Maduranga628/Budget_FC/Documents/Budget_FC_top.png

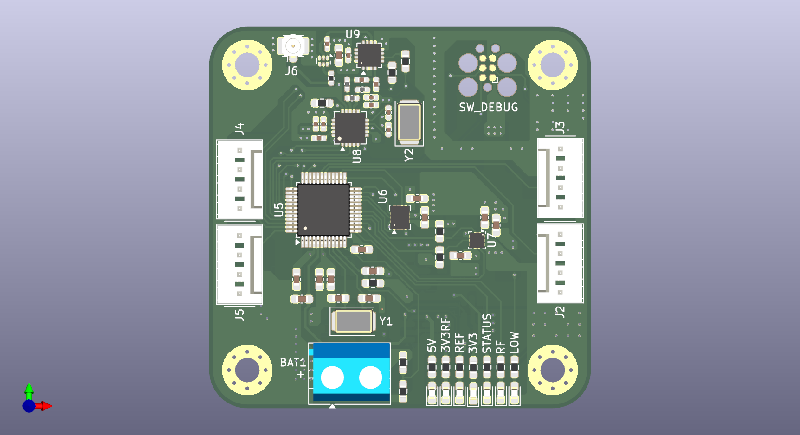
Documents/Budget_FC_top.png
