Maduranga628/Budget_FC/Documents/Budget_FC_bot.png

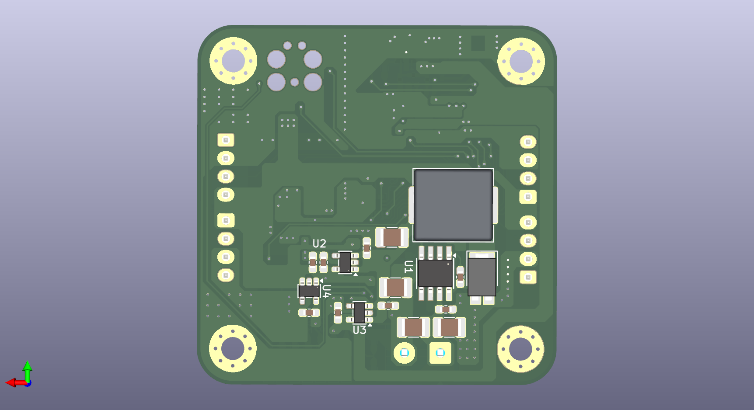
Documents/Budget_FC_bot.png
