Maduranga628/Budget_FC/Documents/Budget_FC.pdf

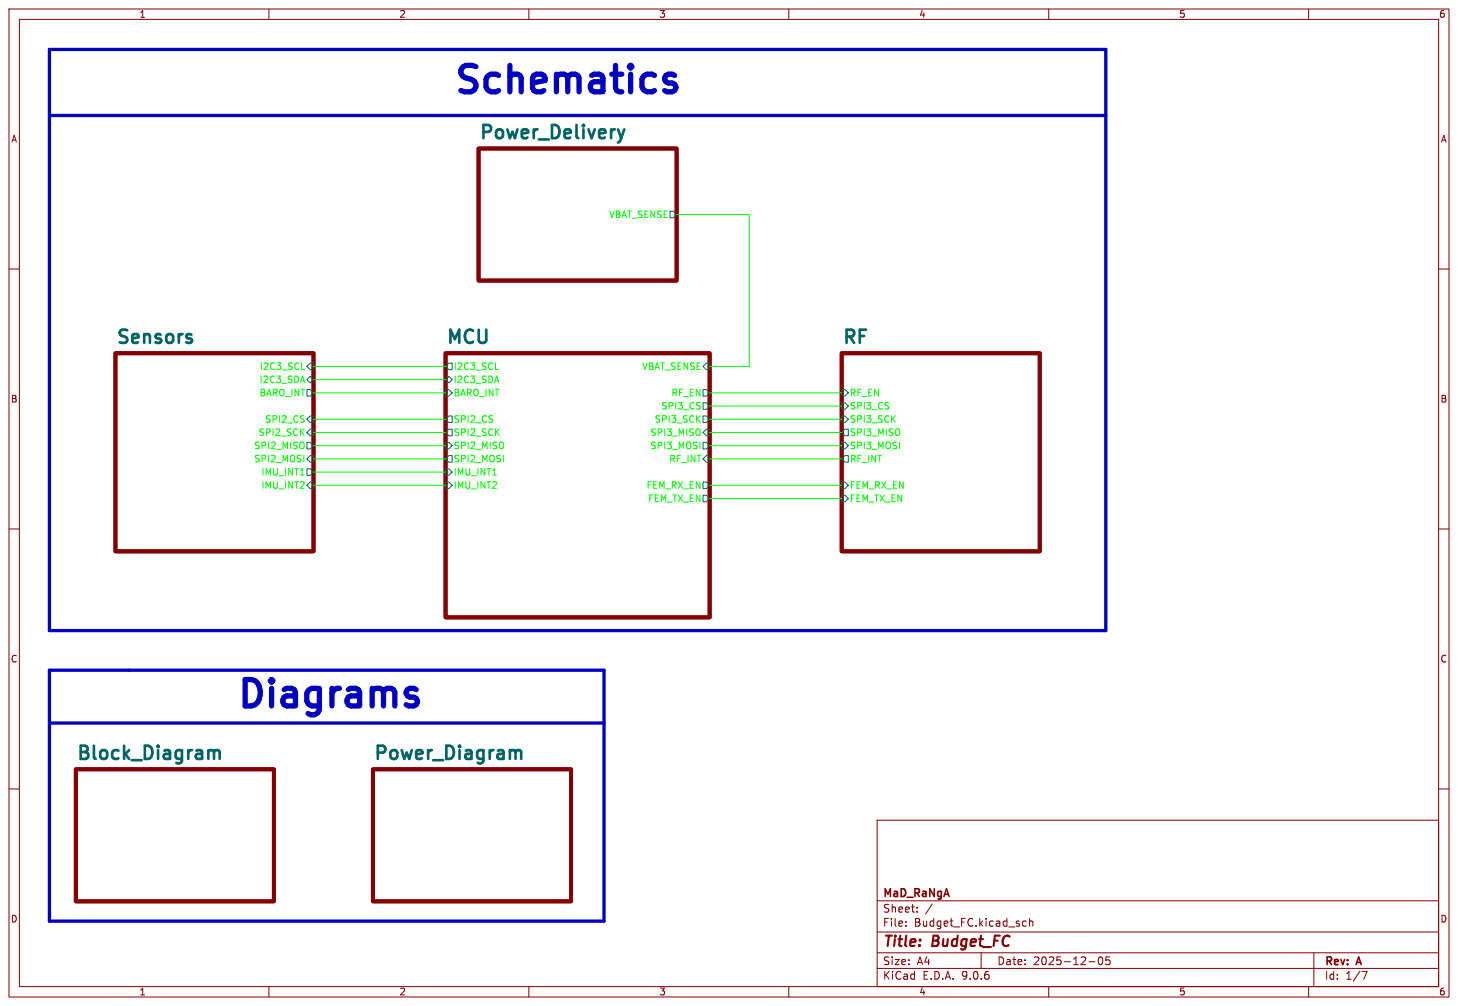
[picture p3: page 1]

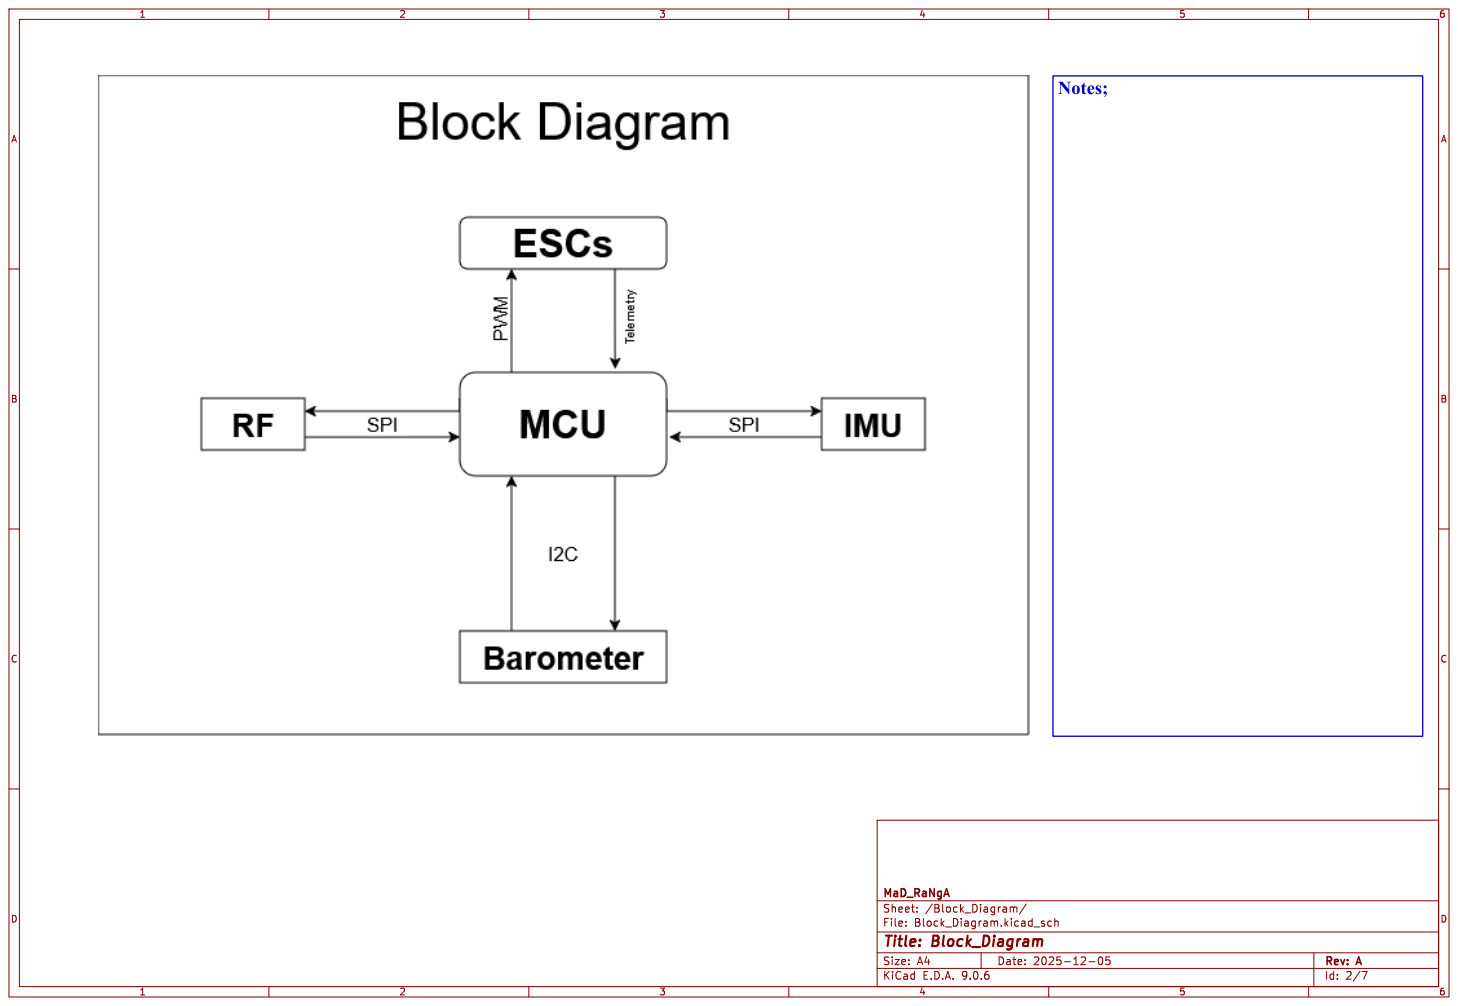
[picture p4: page 2]

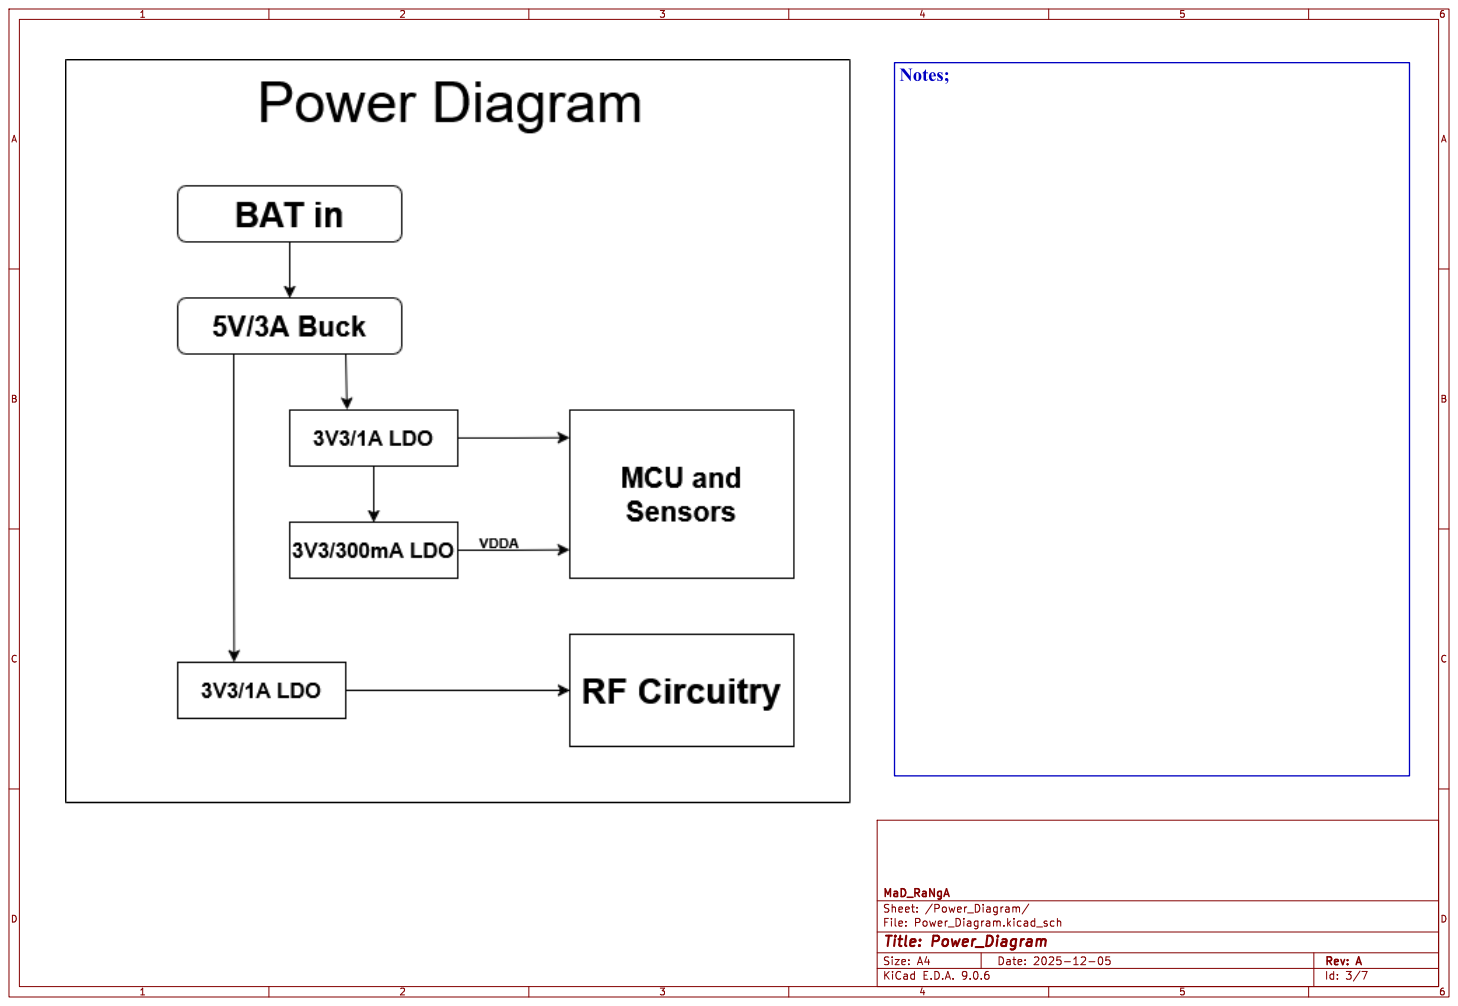
[picture p5: page 3]

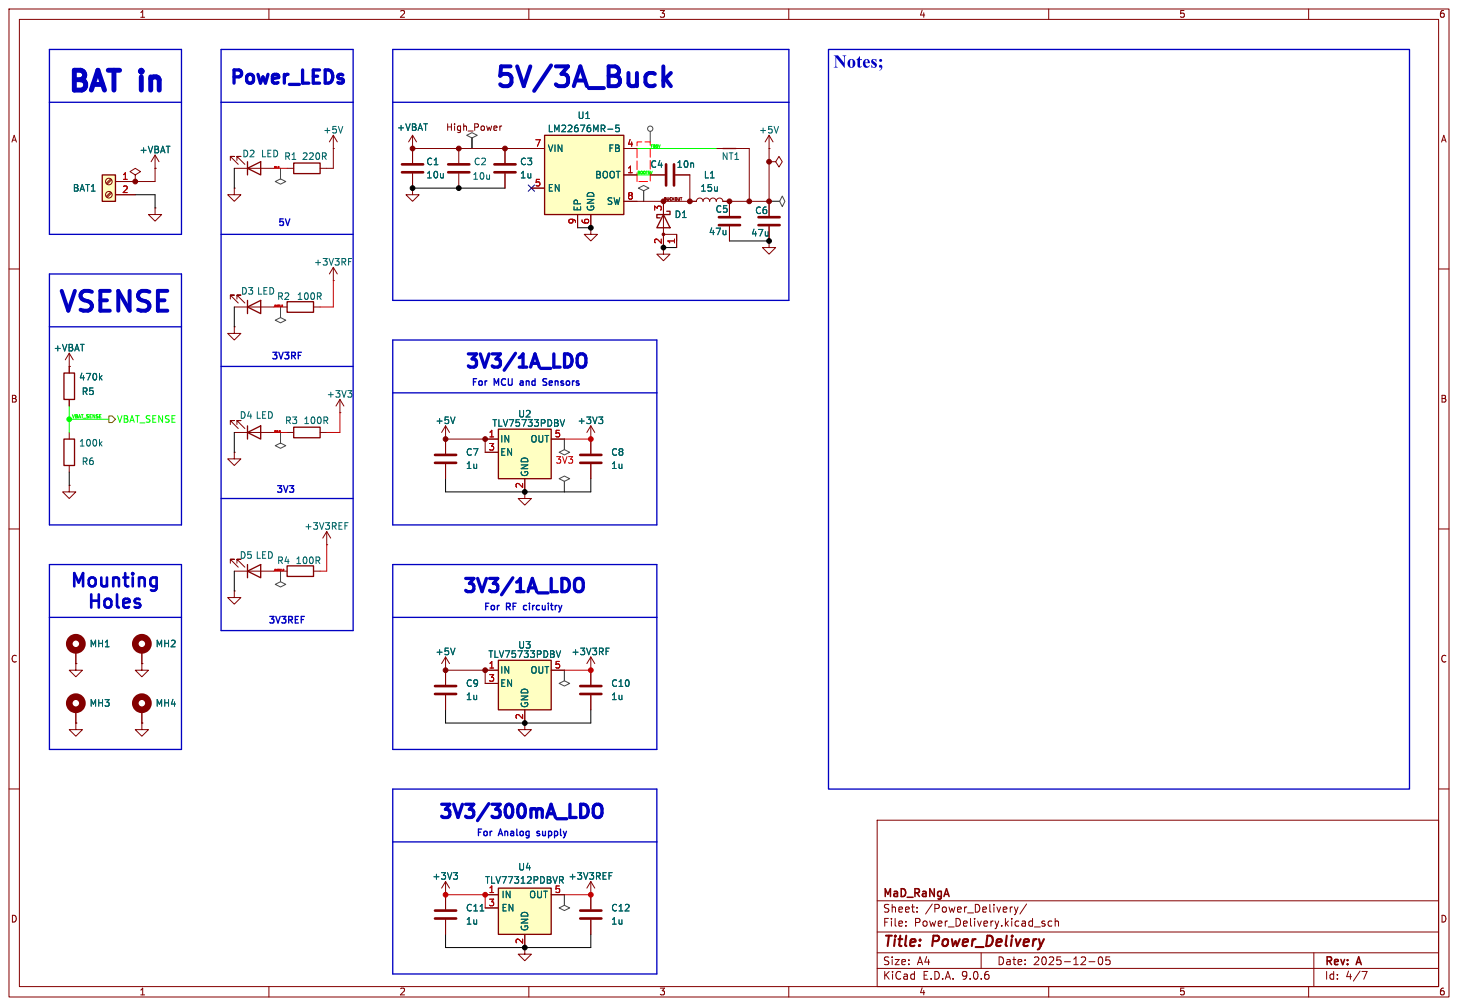
[picture p6: page 4]

For MCU and Sensors

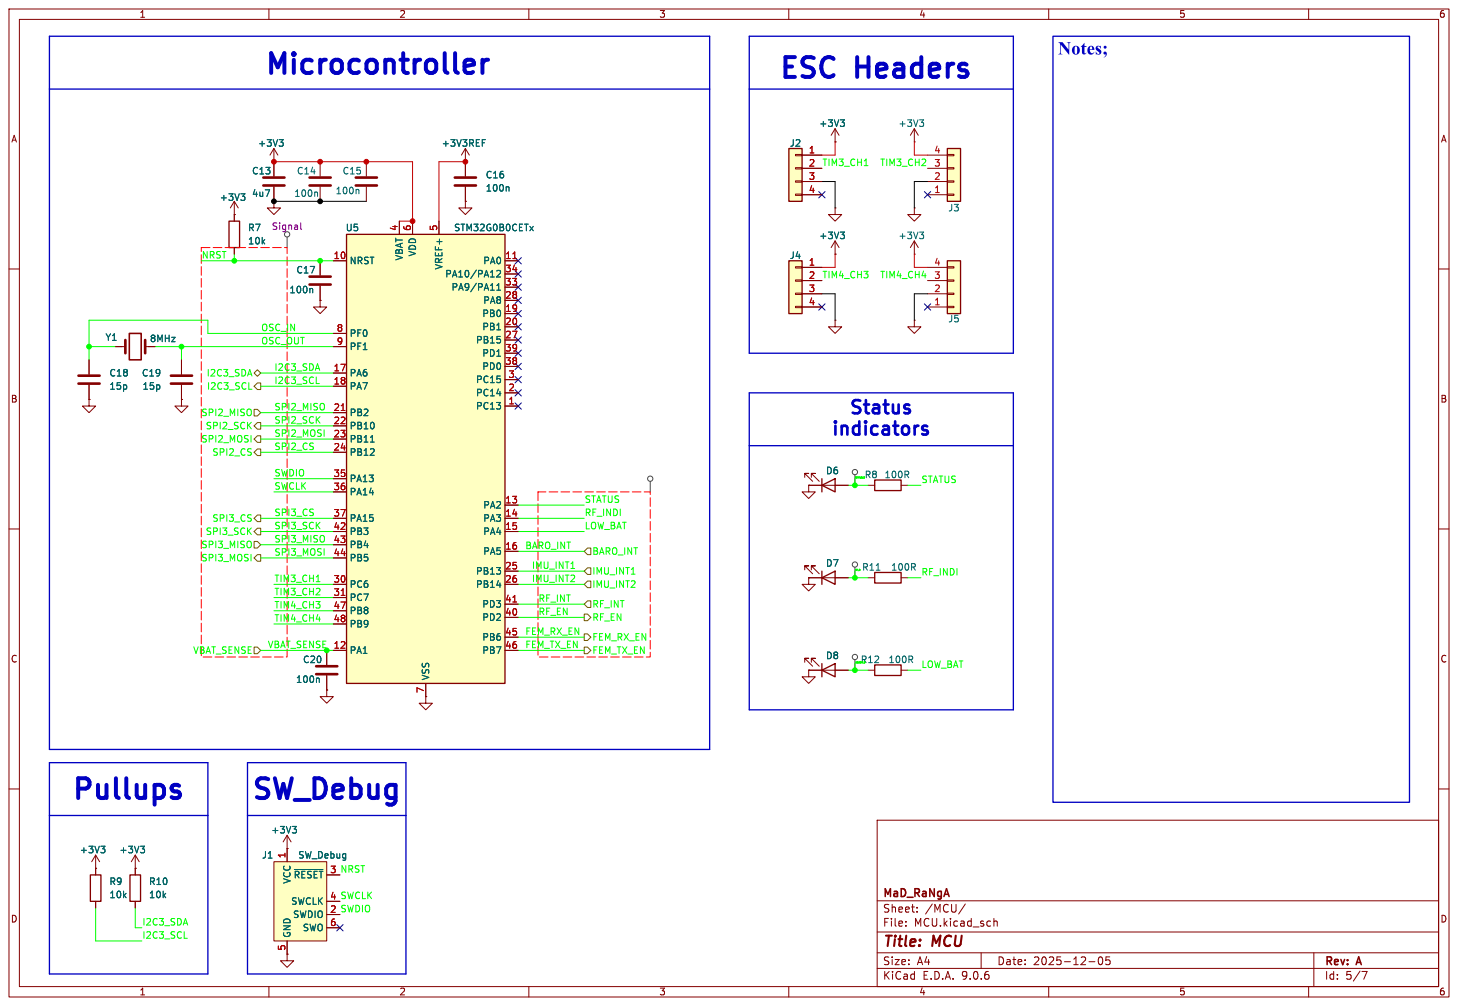
[picture p7: page 5]

File: MCU.kicad_sch Sheet: /MCU/ MaD_RaNgA

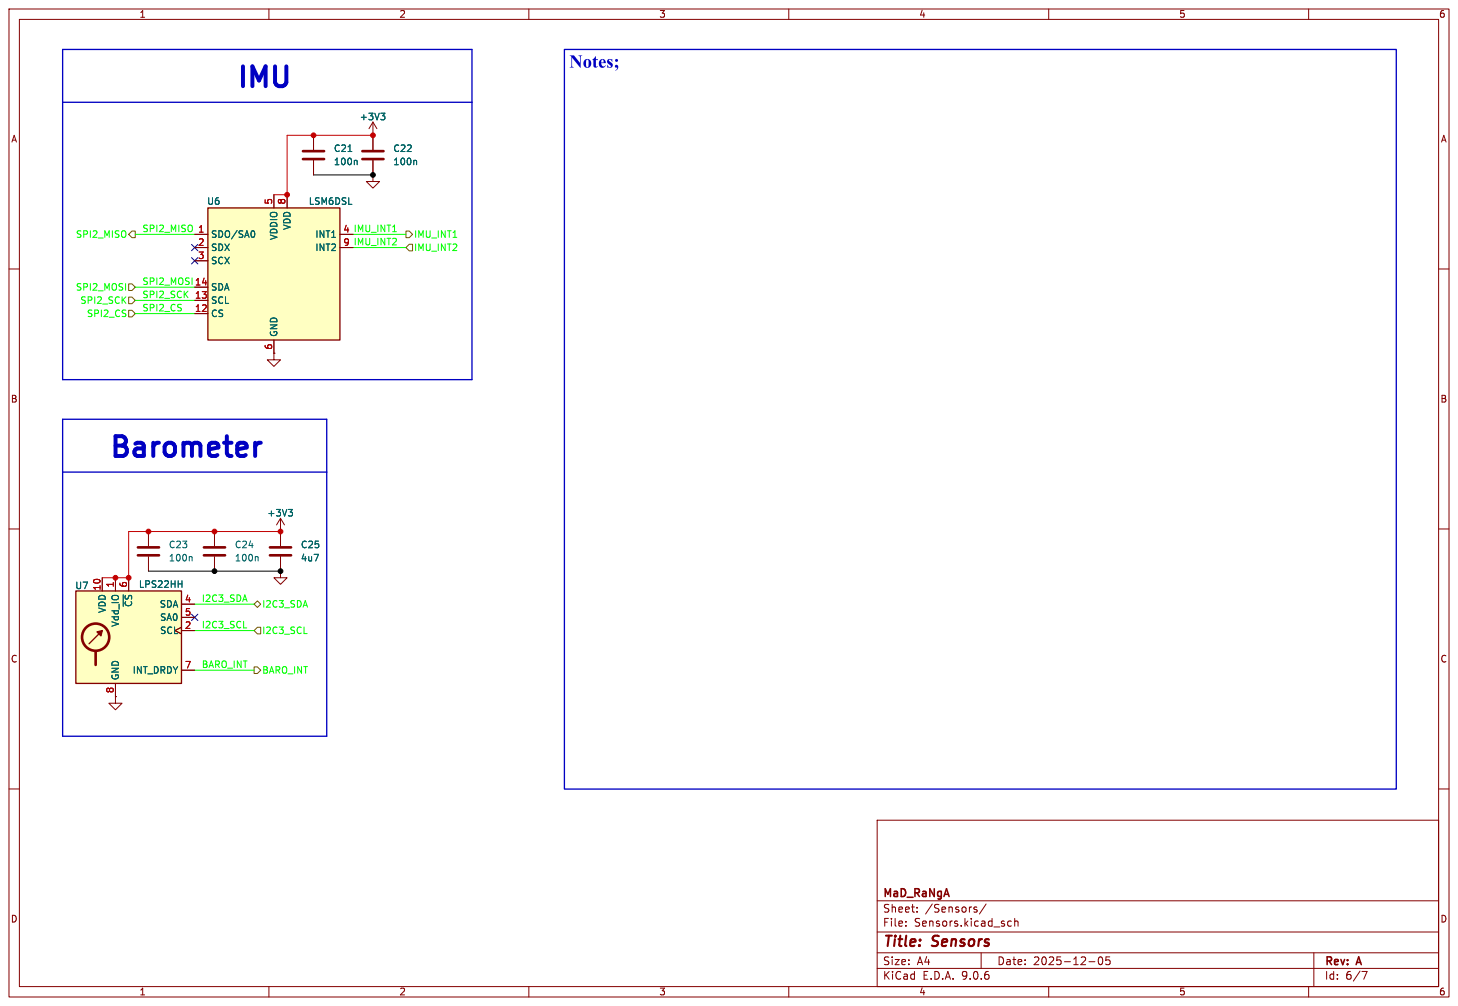
[picture p8: page 6]

File: Sensors.kicad_sch Sheet: /Sensors/ MaD_RaNgA

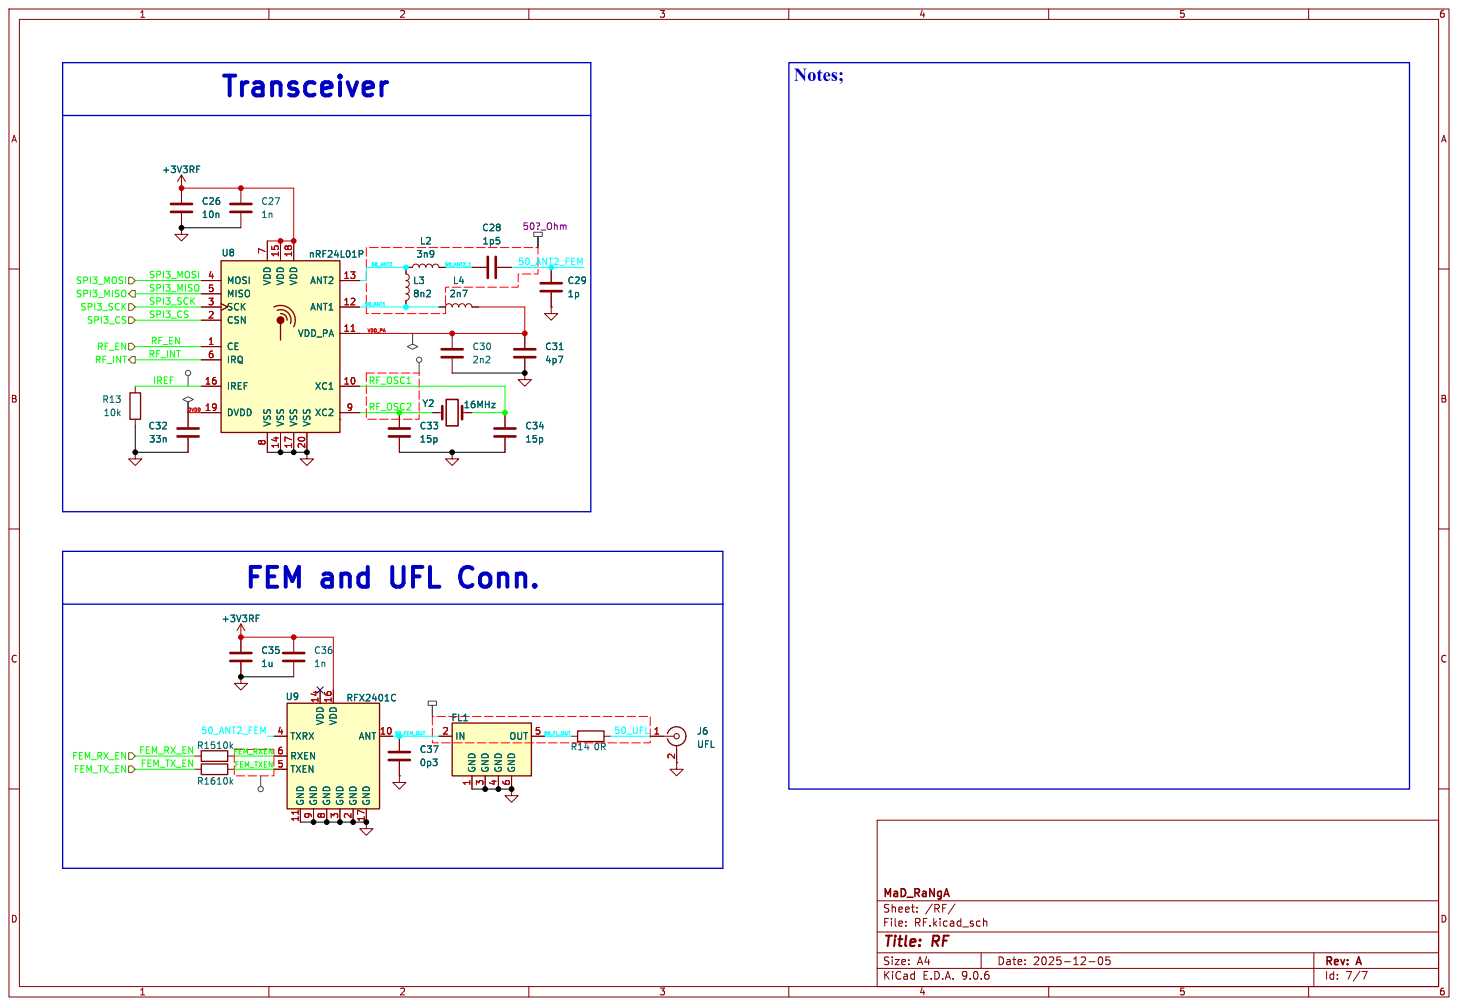
[picture p9: page 7]

8 VDD 15 VSS 14 VDD 18 VSS 17 VSS 20 ANT2 13 ANT1 12 VDD_PA 11 XC1 10 XC2 9 C26

8 VDD 15 VSS 14 VDD 18 VSS 17 VSS 20 ANT2 13 ANT1 12 VDD_PA 11 XC1 10 XC2 9 U8 nRF24L01P

FEM and UFL Conn.

File: RF.kicad_sch Sheet: /RF/ MaD_RaNgA
