Maduranga628/Budget_FC/Documents/Budget_FC_PCB.pdf

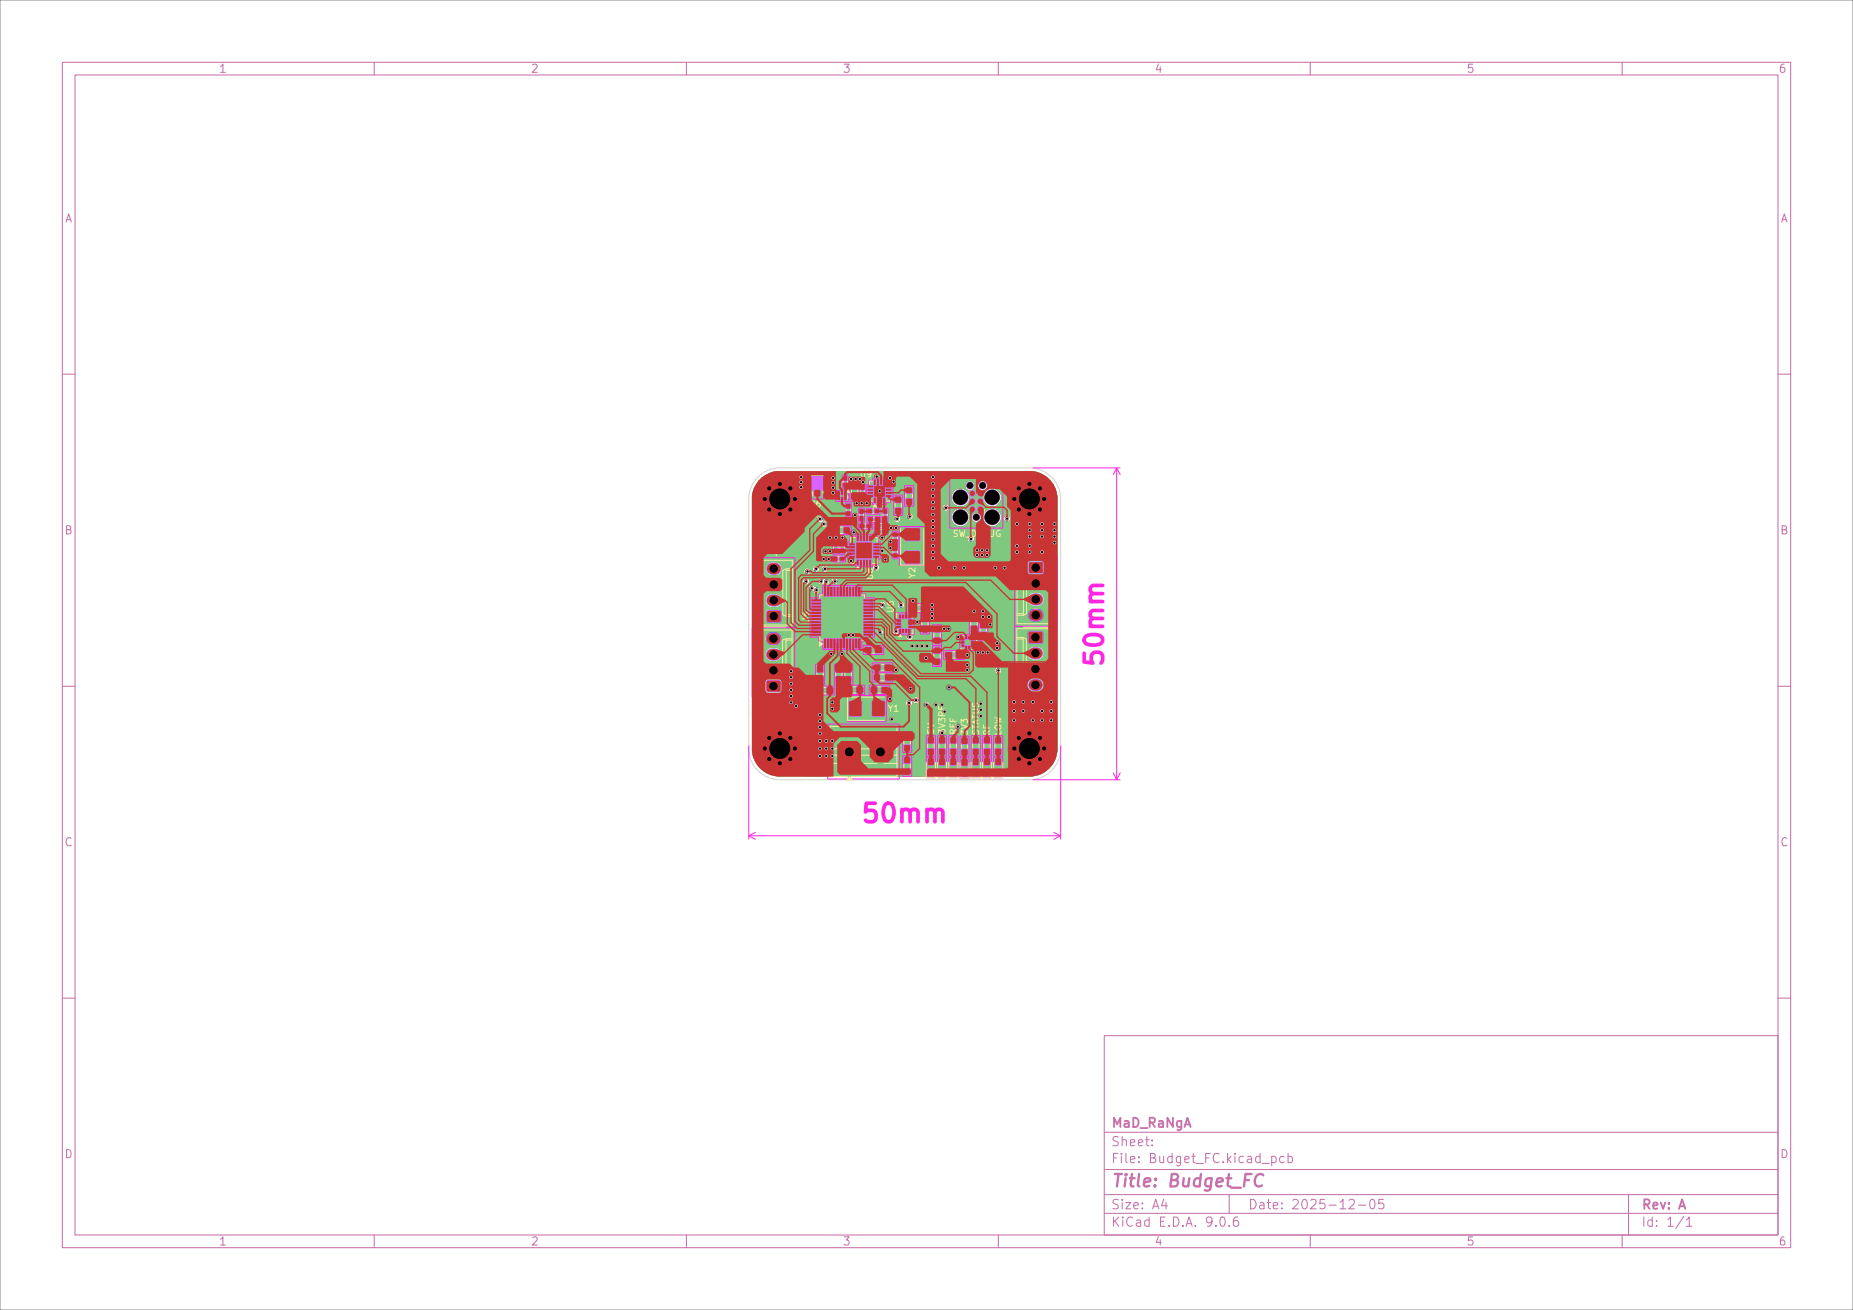
[picture p10: page 1]
