Maduranga628/Budget_FC/Design_Files/Budget_FC.kicad_pcb

## KiCad design Design_Files/Budget_FC.kicad_pcb (2025-12-11)

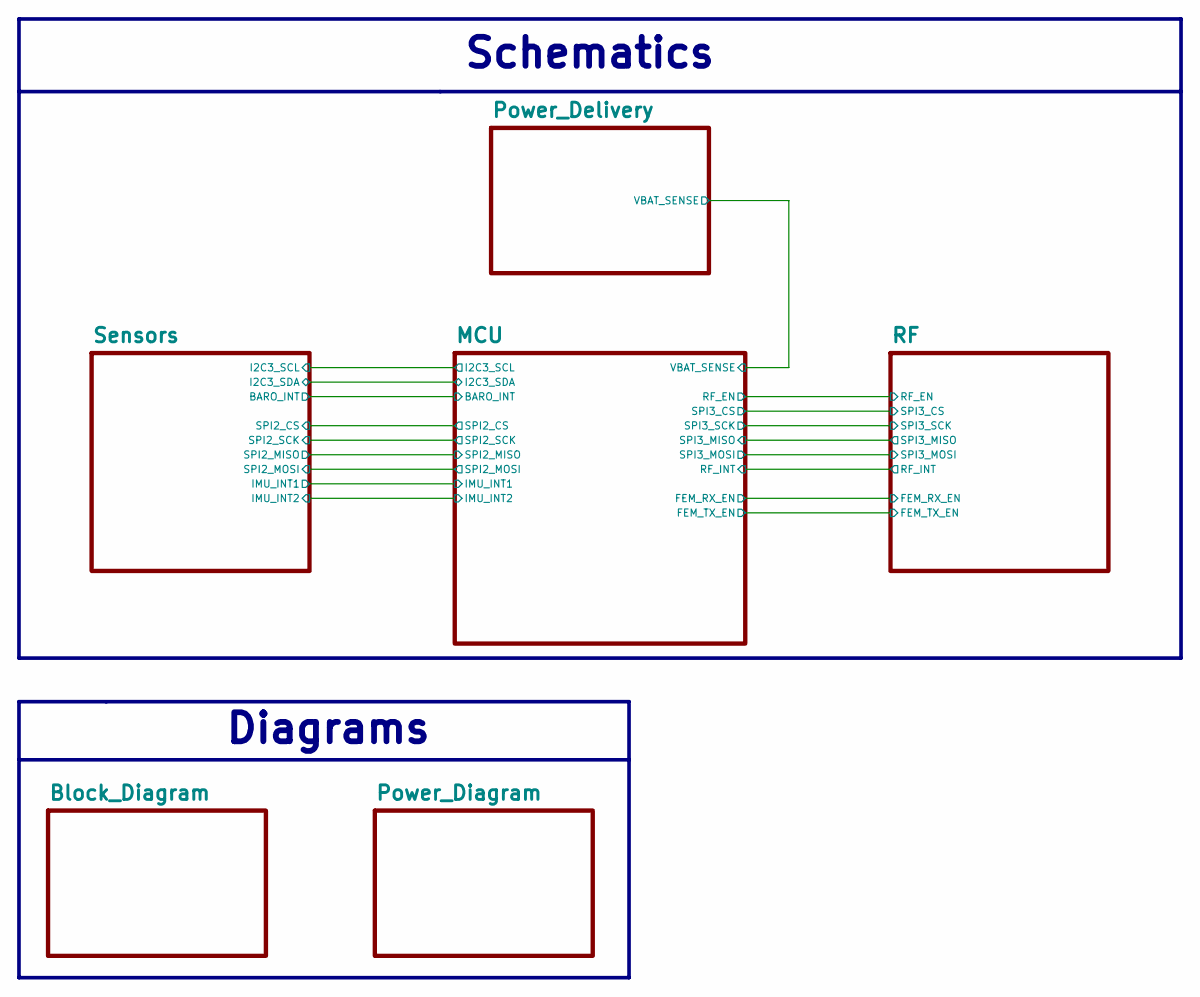
[picture p11: schematic Budget_FC.kicad_sch]

Notes on the sheet:
Schematics
Diagrams

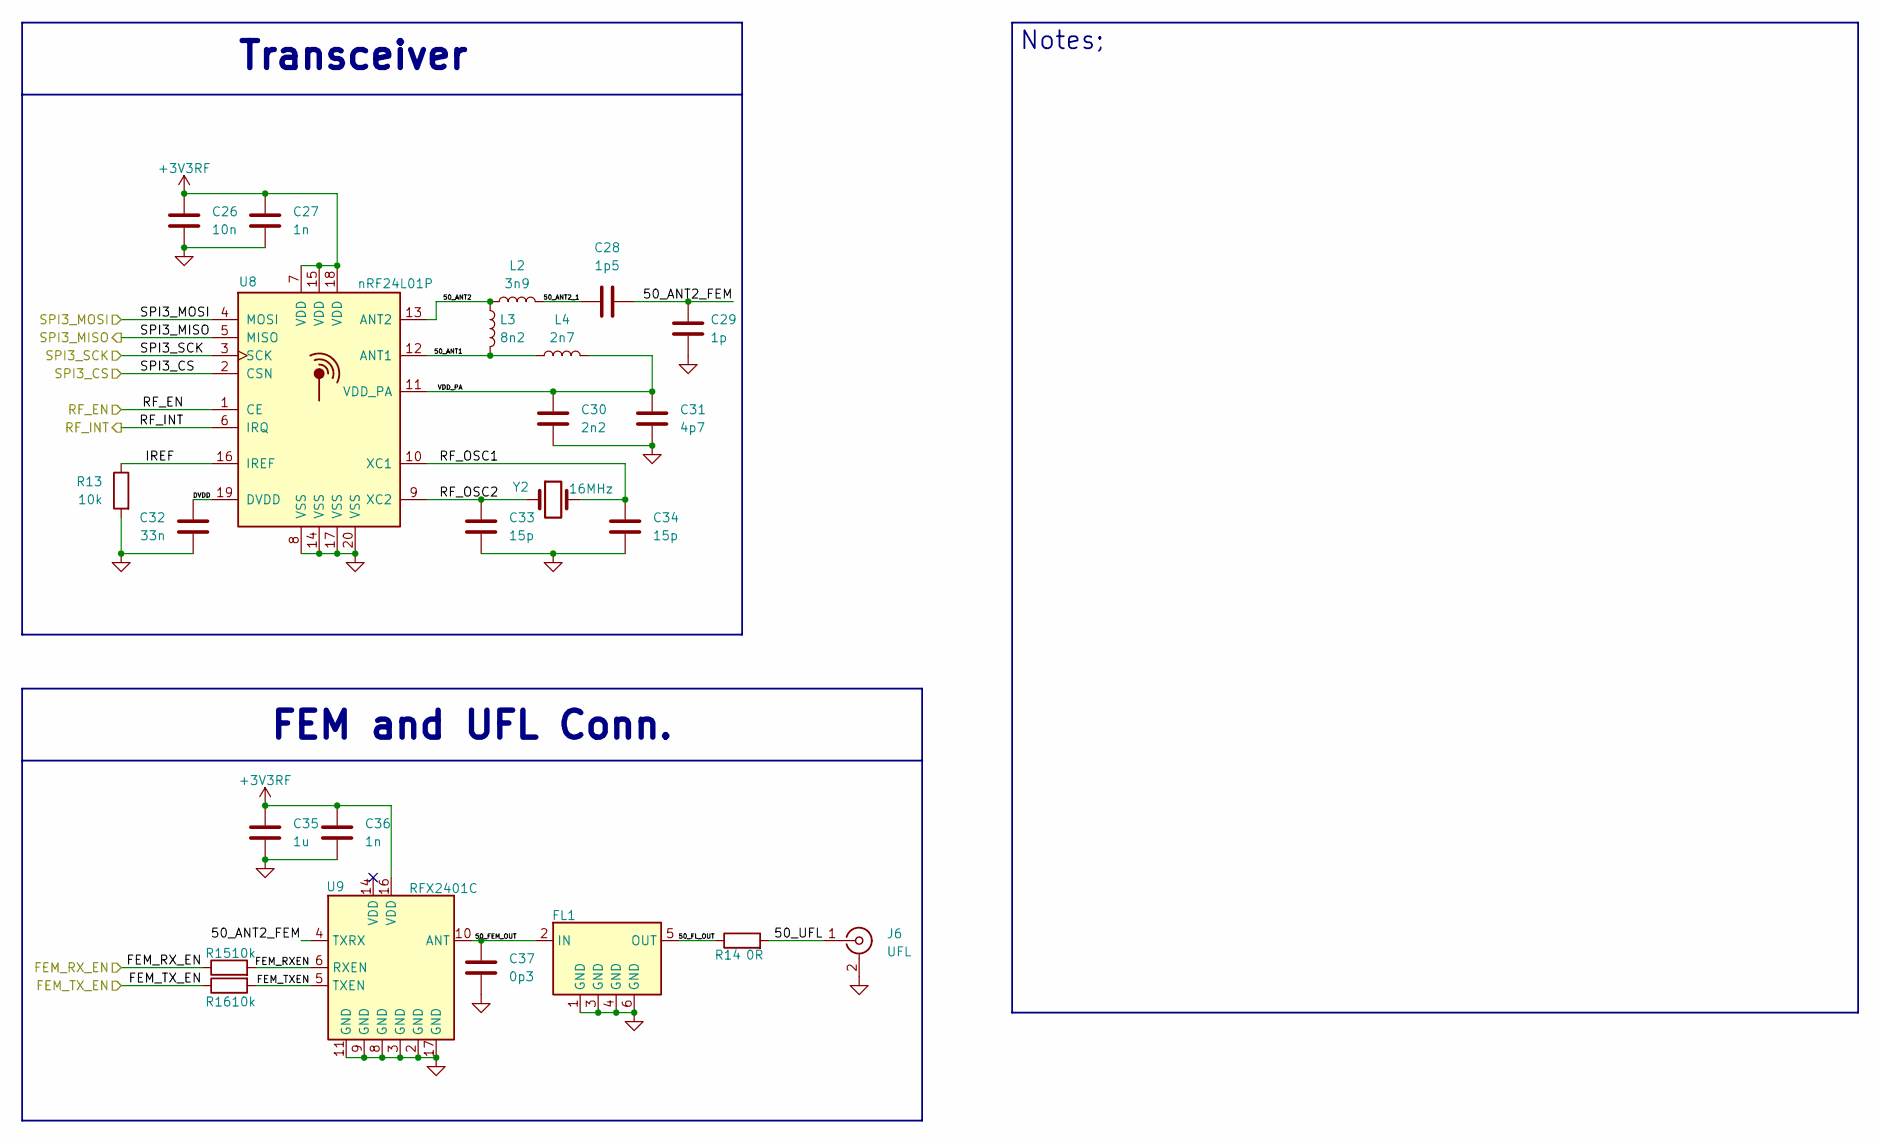
[picture p12: schematic RF.kicad_sch]

Parts:
C26: 10n; C_0402_1005Metric_Pad0.74x0.62mm_HandSolder; Manufacturer Part No. CC0402KRX7R9BB103; LCSC No. C60133
C27, C36: 1n; C_0402_1005Metric_Pad0.74x0.62mm_HandSolder; Manufacturer Part No. CC0402KRX7R9BB102; LCSC No. C106205
C28: 1p5; C_0402_1005Metric_Pad0.74x0.62mm_HandSolder; Manufacturer Part No. CC0402CRNPO9BN1R5; LCSC No. C189471
C29: 1p; C_0402_1005Metric_Pad0.74x0.62mm_HandSolder; Manufacturer Part No. CC0402CRNPO9BN1R0; LCSC No. C277493
C30: 2n2; C_0402_1005Metric_Pad0.74x0.62mm_HandSolder; Manufacturer Part No. CC0402KRX7R9BB222; LCSC No. C106861
C31: 4p7; C_0402_1005Metric_Pad0.74x0.62mm_HandSolder; Manufacturer Part No. CC0402CRNPO9BN4R7; LCSC No. C189469
C32: 33n; C_0402_1005Metric_Pad0.74x0.62mm_HandSolder; Manufacturer Part No. CC0402KRX7R9BB333; LCSC No. C106862
C33, C34: 15p; C_0402_1005Metric_Pad0.74x0.62mm_HandSolder; Manufacturer Part No. CC0402FRNPO9BN150; LCSC No. C326803
C35: 1u; C_0603_1608Metric_Pad1.08x0.95mm_HandSolder; Manufacturer Part No. C1608X5R1E105K080AC; Mouser No. 810-C1608X5R1E105K
C37: 0p3; C_0402_1005Metric_Pad0.74x0.62mm_HandSolder; Manufacturer Part No. CQ0402BRNPO9BNR30; LCSC No. C723570
FL1: 2450LP14A0100001T; Balun_Johanson_1.6x0.8mm; Manufacturer Part No. 2450LP14A0100001T; LCSC No. C17651741
J6: UFL; U.FL_Hirose_U.FL-R-SMT-1_Vertical
L2: 3n9; L_0402_1005Metric_Pad0.77x0.64mm_HandSolder; Manufacturer Part No. CS0402-3N9J-S; LCSC No. C329623
L3: 8n2; L_0402_1005Metric_Pad0.77x0.64mm_HandSolder; Manufacturer Part No. CLH1005T-8N2J-S; LCSC No. C108262
L4: 2n7; L_0402_1005Metric_Pad0.77x0.64mm_HandSolder; Manufacturer Part No. CS0402-2N7J-S; LCSC No. C142181
R13: 10k; R_0603_1608Metric_Pad0.98x0.95mm_HandSolder; Manufacturer Part No. RC0603FR-0722KL; LCSC No. C114065
R14: 0R; R_0402_1005Metric_Pad0.72x0.64mm_HandSolder; Manufacturer Part No. RC0402FR-070RL; LCSC No. C106231
R15, R16: 10k; R_0603_1608Metric_Pad0.98x0.95mm_HandSolder; Manufacturer Part No. RC0603FR-0710KL; LCSC No. C98220
U8: nRF24L01P; QFN-20-1EP_4x4mm_P0.5mm_EP2.5x2.5mm; Manufacturer Part No. NRF24L01P-R7; Mouser No. 949-NRF24L01P-R7
U9: RFX2401C; QFN-16-1EP_3x3mm_P0.5mm_EP1.7x1.7mm; Manufacturer Part No. RFX2401C; Mouser No. 477-RFX2401C
Y2: 16MHz; Crystal_SMD_5032-2Pin_5.0x3.2mm; Manufacturer Part No. 0153G2-16.000F12DTLJL; LCSC No. C19674297

Connections:
+3V3RF: C26.1, C27.1, C35.1, C36.1, U8.7 (VDD), U8.15 (VDD), U8.18 (VDD), U9.16 (VDD); also elsewhere on the board
/MCU/FEM_RX_EN: R15.1; also elsewhere on the board
/MCU/FEM_TX_EN: R16.1; also elsewhere on the board
/MCU/RF_EN: U8.1 (CE); also elsewhere on the board
/MCU/RF_INT: U8.6 (IRQ); also elsewhere on the board
/MCU/SPI3_CS: U8.2 (CSN); also elsewhere on the board
/MCU/SPI3_MISO: U8.5 (MISO); also elsewhere on the board
/MCU/SPI3_MOSI: U8.4 (MOSI); also elsewhere on the board
/MCU/SPI3_SCK: U8.3 (SCK); also elsewhere on the board
/RF/50_ANT1: L3.2, L4.1, U8.12 (ANT1)
/RF/50_ANT2: L2.1, L3.1, U8.13 (ANT2)
/RF/50_ANT2_1: C28.1, L2.2
/RF/50_ANT2_FEM: C28.2, C29.1, U9.4 (TXRX)
/RF/50_FEM_OUT: C37.1, FL1.2 (IN), U9.10 (ANT)
/RF/50_FL_OUT: FL1.5 (OUT), R14.1
/RF/50_UFL: J6.1 (In), R14.2
/RF/DVDD: C32.1, U8.19 (DVDD)
/RF/FEM_RXEN: R15.2, U9.6 (RXEN)
/RF/FEM_TXEN: R16.2, U9.5 (TXEN)
/RF/IREF: R13.1, U8.16 (IREF)
/RF/RF_OSC1: C34.1, U8.10 (XC1), Y2.2
/RF/RF_OSC2: C33.1, U8.9 (XC2), Y2.1
/RF/VDD_PA: C30.1, C31.1, L4.2, U8.11 (VDD_PA)
GND: C26.2, C27.2, C29.2, C30.2, C31.2, C32.2, C33.2, C34.2, C35.2, C36.2, C37.2, FL1.1 (GND), FL1.3 (GND), FL1.4 (GND), FL1.6 (GND), J6.2 (Ext), R13.2, U8.8 (VSS), U8.14 (VSS), U8.17 (VSS), U8.20 (VSS), U9.2 (GND), U9.3 (GND), U9.8 (GND), U9.9 (GND), U9.11 (GND), U9.17 (GND); also elsewhere on the board

Notes on the sheet:
Transceiver
FEM and UFL Conn.
Notes;

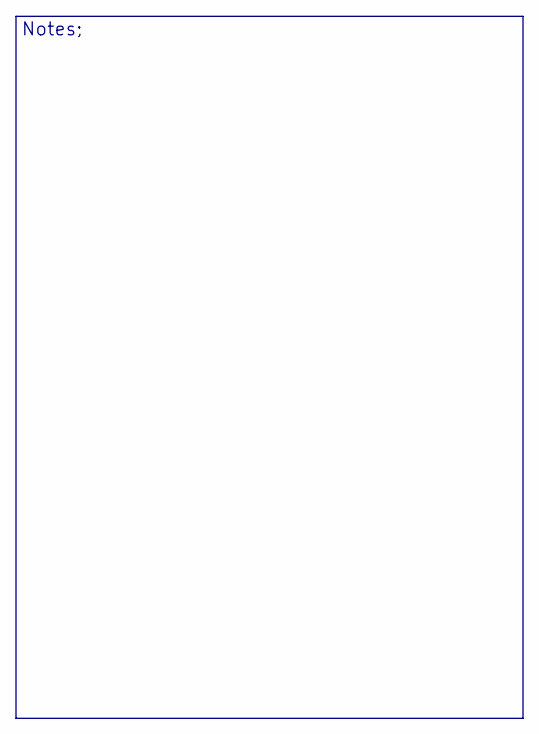
[picture p13: schematic Power_Diagram.kicad_sch]

Notes on the sheet:
Notes;

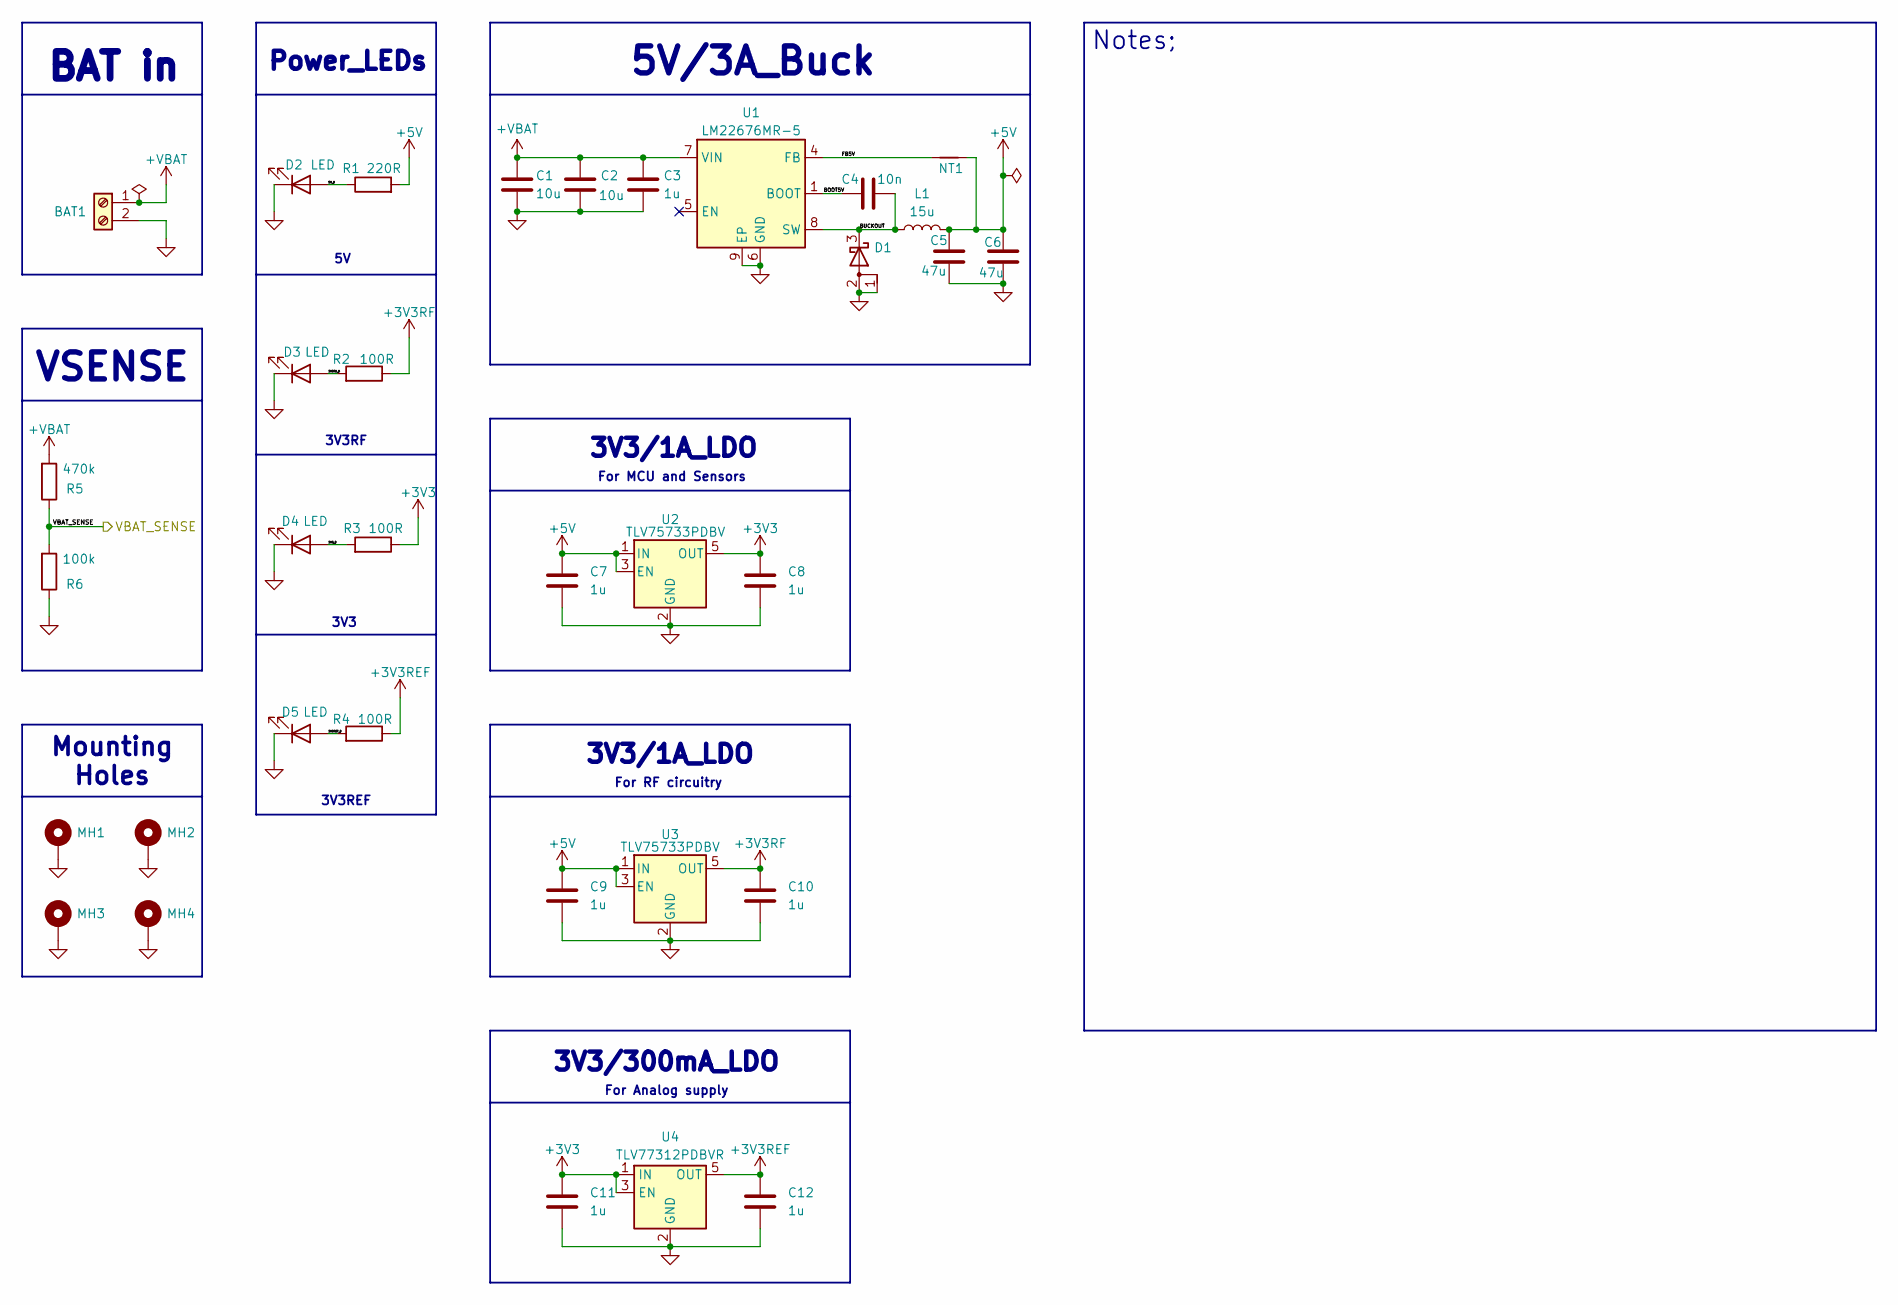
[picture p14: schematic Power_Delivery.kicad_sch]

Parts:
BAT1: Screw_Terminal_01x02; TerminalBlock_MaiXu_MX126-5.0-02P_1x02_P5.00mm_3d
C1, C2: 10u; C_1210_3225Metric_Pad1.33x2.70mm_HandSolder; Manufacturer Part No. C3225X7R1H106M250AC; Mouser No. 810-C3225X7R1H106MAC
C3, C7, C8, C9, C10, C11, C12: 1u; C_0603_1608Metric_Pad1.08x0.95mm_HandSolder; Manufacturer Part No. C1608X5R1E105K080AC; Mouser No. 810-C1608X5R1E105K
C4: 10n; C_0603_1608Metric_Pad1.08x0.95mm_HandSolder; Manufacturer Part No. C0603C103K5RACTU; Mouser No. 80-C0603C103K5R
C5, C6: 47u; C_1210_3225Metric_Pad1.33x2.70mm_HandSolder; Manufacturer Part No. GRM32ER61C476KE15L; Mouser No. 81-GRM32ER61C476KE5L
D1: D_Schottky_AAK; Diode_SMD_D_PowerDI-5; Manufacturer Part No. PDS760-13; Mouser No. 621-PDS760-F
D2, D3, D4, D5: LED; LED_0603_1608Metric_Pad1.05x0.95mm_HandSolder; Manufacturer Part No. XL-1608UBC-04; LCSC No. C965807
L1: 15u; L_Bourns_SRP1050WA; Manufacturer Part No. ZD1040-150M; LCSC No. C46956567
MH1, MH2, MH3, MH4: MountingHole_Pad; MountingHole_3.2mm_M3_Pad_Via
NT1: NetTie_2; NetTie-2_SMD_Pad0.5mm
R1: 220R; R_0603_1608Metric_Pad0.98x0.95mm_HandSolder; Manufacturer Part No. RC0603FR-07220RL; LCSC No. C107696
R2, R3, R4: 100R; R_0603_1608Metric_Pad0.98x0.95mm_HandSolder; Manufacturer Part No. RC0603FR-07100RL; LCSC No. C105588
R5: 470k; R_0603_1608Metric_Pad0.98x0.95mm_HandSolder; Manufacturer Part No. RC0603FR-07470KL; LCSC No. C114622
R6: 100k; R_0603_1608Metric_Pad0.98x0.95mm_HandSolder; Manufacturer Part No. RC0603FR-07100KL; LCSC No. C14675
U1: LM22676MR-5; TI_SO-PowerPAD-8; Manufacturer Part No. LM22676QMRX-5.0/NOPB; Mouser No. 926-LM22676QMRX50NPB
U2, U3: TLV75733PDBV; SOT-23-5; Manufacturer Part No. TLV75733PDBVR; Mouser No. 595-TLV75733PDBVR
U4: TLV77312PDBVR; SOT-23-5; Manufacturer Part No. TLV77312PDBVR; Mouser No. 595-TLV77312PDBVR

Connections:
+3V3: C8.1, C11.1, R3.1, U2.5 (OUT), U4.1 (IN), U4.3 (EN); also elsewhere on the board
+3V3REF: C12.1, R4.1, U4.5 (OUT); also elsewhere on the board
+3V3RF: C10.1, R2.1, U3.5 (OUT); also elsewhere on the board
+5V: C5.1, C6.1, C7.1, C9.1, L1.2, NT1.2, R1.2, U2.1 (IN), U2.3 (EN), U3.1 (IN), U3.3 (EN)
+VBAT: BAT1.1, C1.1, C2.1, C3.1, R5.2, U1.7 (VIN)
/MCU/VBAT_SENSE: R5.1, R6.2; also elsewhere on the board
/Power_Delivery/3V3REF_D: D5.2 (A), R4.2; also elsewhere on the board
/Power_Delivery/3V3RF_D: D3.2 (A), R2.2; also elsewhere on the board
/Power_Delivery/3V3_D: D4.2 (A), R3.2; also elsewhere on the board
/Power_Delivery/5V_D: D2.2 (A), R1.1; also elsewhere on the board
/Power_Delivery/BOOT5V: C4.1, U1.1 (BOOT)
/Power_Delivery/BUCKOUT: C4.2, D1.3 (K), L1.1, U1.8 (SW)
/Power_Delivery/FB5V: NT1.1, U1.4 (FB)
GND: BAT1.2, C1.2, C2.2, C3.2, C5.2, C6.2, C7.2, C8.2, C9.2, C10.2, C11.2, C12.2, D1.1 (A), D1.2 (A), D2.1 (K), D3.1 (K), D4.1 (K), D5.1 (K), MH1.1, MH2.1, MH3.1, MH4.1, R6.1, U1.6 (GND), U1.9 (EP), U2.2 (GND), U3.2 (GND), U4.2 (GND); also elsewhere on the board

Notes on the sheet:
3V3/1A_LDO
3V3RF
BAT in
Mounting Holes
3V3REF
Power_LEDs
5V/3A_Buck
For MCU and Sensors
For Analog supply
VSENSE
3V3/300mA_LDO
3V3
For RF circuitry
Notes;

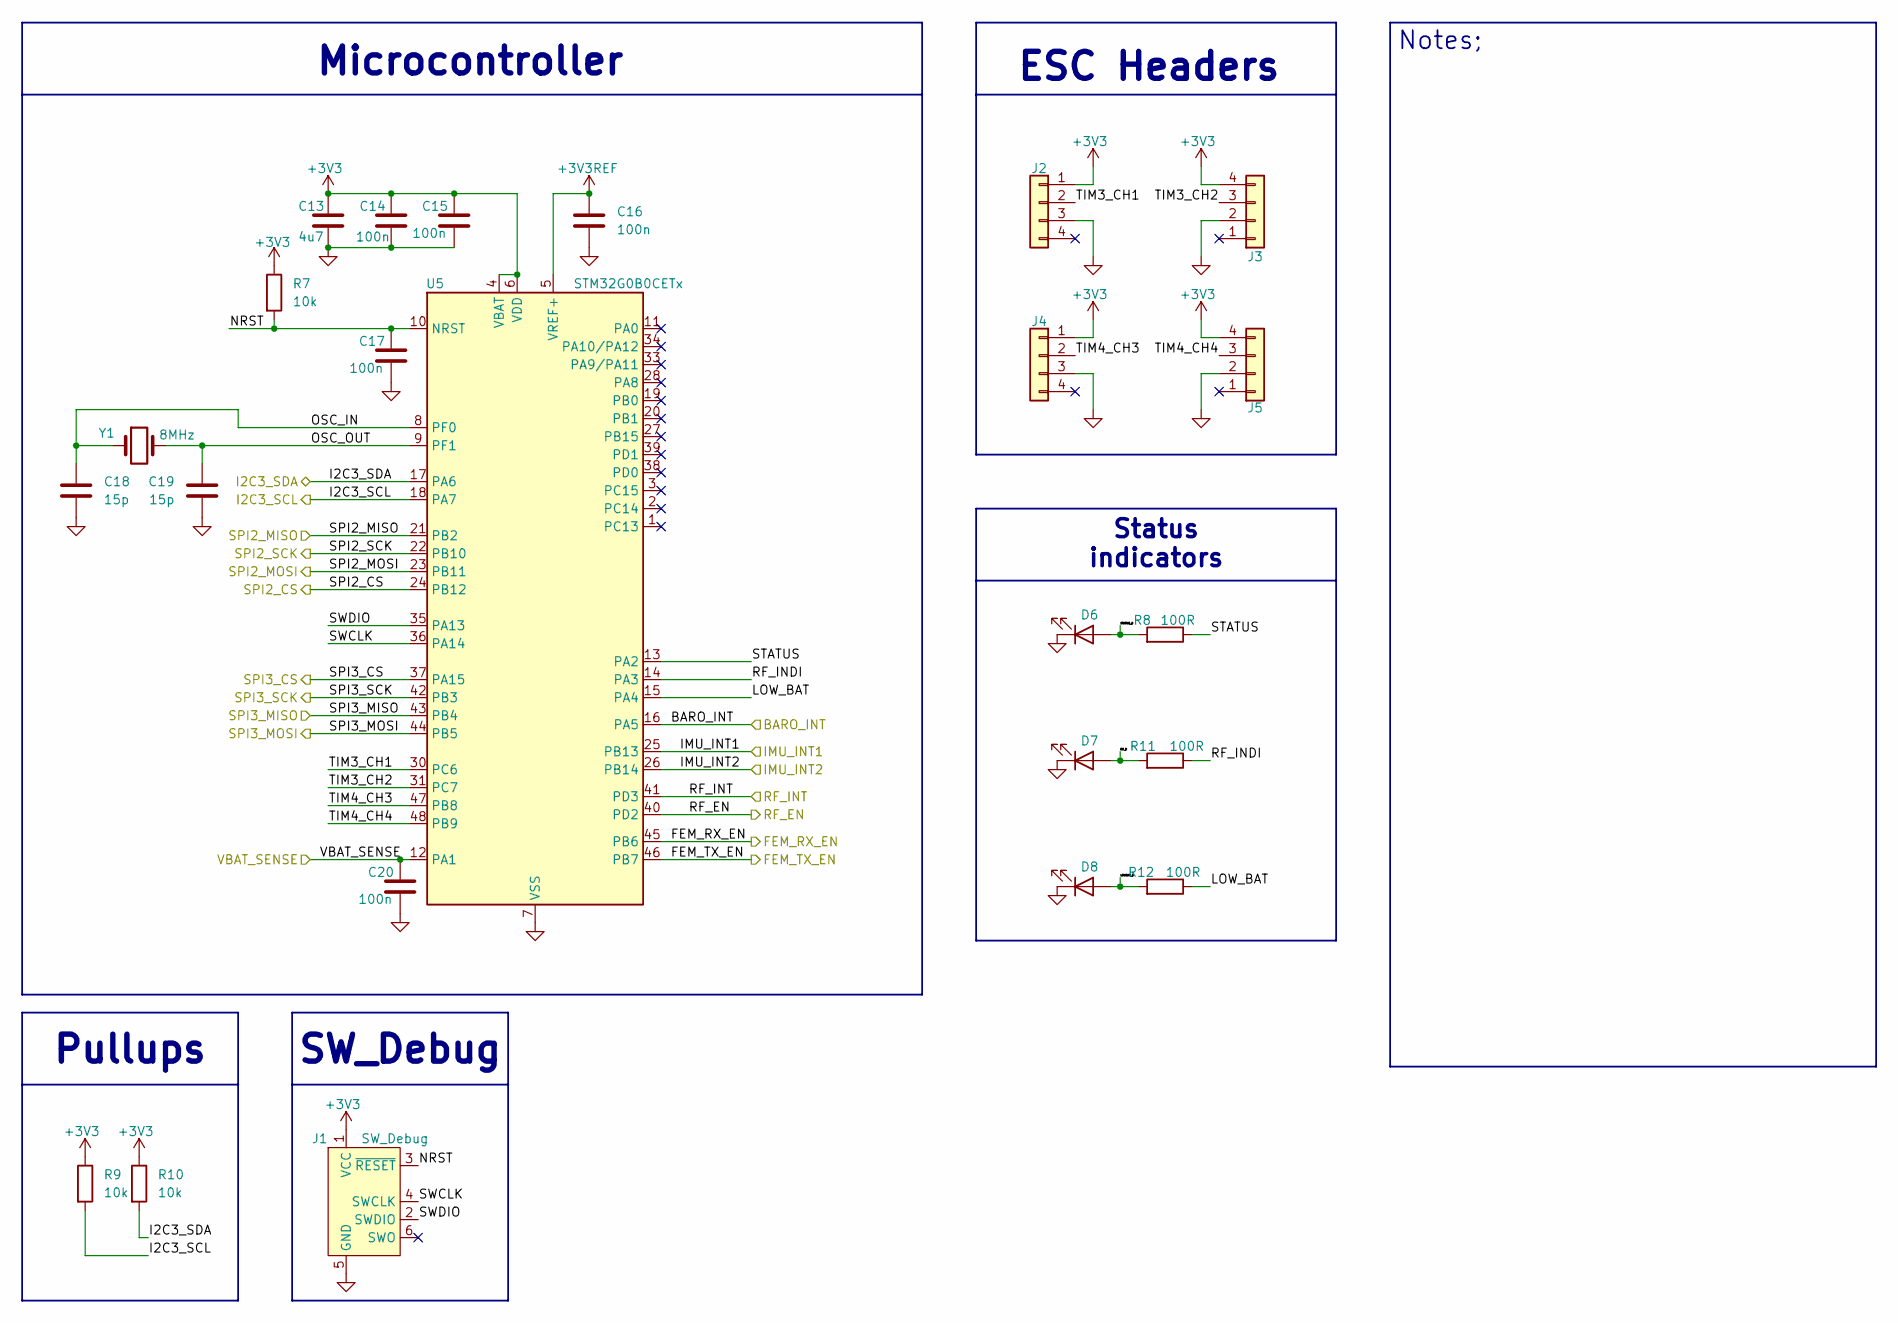
[picture p15: schematic MCU.kicad_sch]

Parts:
C13: 4u7; C_0603_1608Metric_Pad1.08x0.95mm_HandSolder; Manufacturer Part No. CC0603KRX5R6BB475; LCSC No. C109456
C14, C15, C16, C17, C20: 100n; C_0603_1608Metric_Pad1.08x0.95mm_HandSolder; Manufacturer Part No. CC0603KRX7R6BB104; LCSC No. C519438
C18, C19: 15p; C_0603_1608Metric_Pad1.08x0.95mm_HandSolder; Manufacturer Part No. CC0603JRNPO9BN150; LCSC No. C107037
D6, D7, D8: LED; LED_0603_1608Metric_Pad1.05x0.95mm_HandSolder; Manufacturer Part No. XL-1608UBC-04; LCSC No. C965807
J1: SW_Debug; Tag-Connect_TC2030-IDC-FP_2x03_P1.27mm_Vertical
J2, J3, J4, J5: Conn_01x04; Molex_KK-254_AE-6410-04A_1x04_P2.54mm_Vertical
R7, R9, R10: 10k; R_0603_1608Metric_Pad0.98x0.95mm_HandSolder; Manufacturer Part No. RC0603FR-0710KL; LCSC No. C98220
R8, R11, R12: 100R; R_0603_1608Metric_Pad0.98x0.95mm_HandSolder; Manufacturer Part No. RC0603FR-07100RL; LCSC No. C105588
U5: STM32G0B0CETx; LQFP-48_7x7mm_P0.5mm; Manufacturer Part No. STM32G0B0CET6TR; Mouser No. 511-STM32G0B0CET6TR
Y1: 8MHz; Crystal_SMD_5032-2Pin_5.0x3.2mm; Manufacturer Part No. XC53G2-8.000-F12NJHP; LCSC No. C2842269

Connections:
+3V3: C13.1, C14.1, C15.1, J1.1 (VCC), J2.1, J3.4, J4.1, J5.4, R7.1, R9.1, R10.1, U5.4 (VBAT), U5.6 (VDD); also elsewhere on the board
+3V3REF: C16.1, U5.5 (VREF+); also elsewhere on the board
/MCU/BARO_INT: U5.16 (PA5); also elsewhere on the board
/MCU/FEM_RX_EN: U5.45 (PB6); also elsewhere on the board
/MCU/FEM_TX_EN: U5.46 (PB7); also elsewhere on the board
/MCU/I2C3_SCL: R9.2, U5.18 (PA7); also elsewhere on the board
/MCU/I2C3_SDA: R10.2, U5.17 (PA6); also elsewhere on the board
/MCU/IMU_INT1: U5.25 (PB13); also elsewhere on the board
/MCU/IMU_INT2: U5.26 (PB14); also elsewhere on the board
/MCU/LOWBAT_D: D8.2 (A), R12.2; also elsewhere on the board
/MCU/LOW_BAT: R12.1, U5.15 (PA4)
/MCU/NRST: C17.1, J1.3 (~RESET), R7.2, U5.10 (NRST); also elsewhere on the board
/MCU/OSC_IN: C18.1, U5.8 (PF0), Y1.1
/MCU/OSC_OUT: C19.1, U5.9 (PF1), Y1.2
/MCU/RF_D: D7.2 (A), R11.2; also elsewhere on the board
/MCU/RF_EN: U5.40 (PD2); also elsewhere on the board
/MCU/RF_INDI: R11.1, U5.14 (PA3)
/MCU/RF_INT: U5.41 (PD3); also elsewhere on the board
/MCU/SPI2_CS: U5.24 (PB12); also elsewhere on the board
/MCU/SPI2_MISO: U5.21 (PB2); also elsewhere on the board
/MCU/SPI2_MOSI: U5.23 (PB11); also elsewhere on the board
/MCU/SPI2_SCK: U5.22 (PB10); also elsewhere on the board
/MCU/SPI3_CS: U5.37 (PA15); also elsewhere on the board
/MCU/SPI3_MISO: U5.43 (PB4); also elsewhere on the board
/MCU/SPI3_MOSI: U5.44 (PB5); also elsewhere on the board
/MCU/SPI3_SCK: U5.42 (PB3); also elsewhere on the board
/MCU/STATUS: R8.1, U5.13 (PA2)
/MCU/STATUS_D: D6.2 (A), R8.2; also elsewhere on the board
/MCU/SWCLK: J1.4 (SWCLK), U5.36 (PA14); also elsewhere on the board
/MCU/SWDIO: J1.2 (SWDIO), U5.35 (PA13); also elsewhere on the board
/MCU/TIM3_CH1: J2.2, U5.30 (PC6)
/MCU/TIM3_CH2: J3.3, U5.31 (PC7)
/MCU/TIM4_CH3: J4.2, U5.47 (PB8)
/MCU/TIM4_CH4: J5.3, U5.48 (PB9)
/MCU/VBAT_SENSE: C20.1, U5.12 (PA1); also elsewhere on the board
GND: C13.2, C14.2, C15.2, C16.2, C17.2, C18.2, C19.2, C20.2, D6.1 (K), D7.1 (K), D8.1 (K), J1.5 (GND), J2.3, J3.2, J4.3, J5.2, U5.7 (VSS); also elsewhere on the board

Notes on the sheet:
Pullups
SW_Debug
ESC Headers
Microcontroller
Status indicators
Notes;

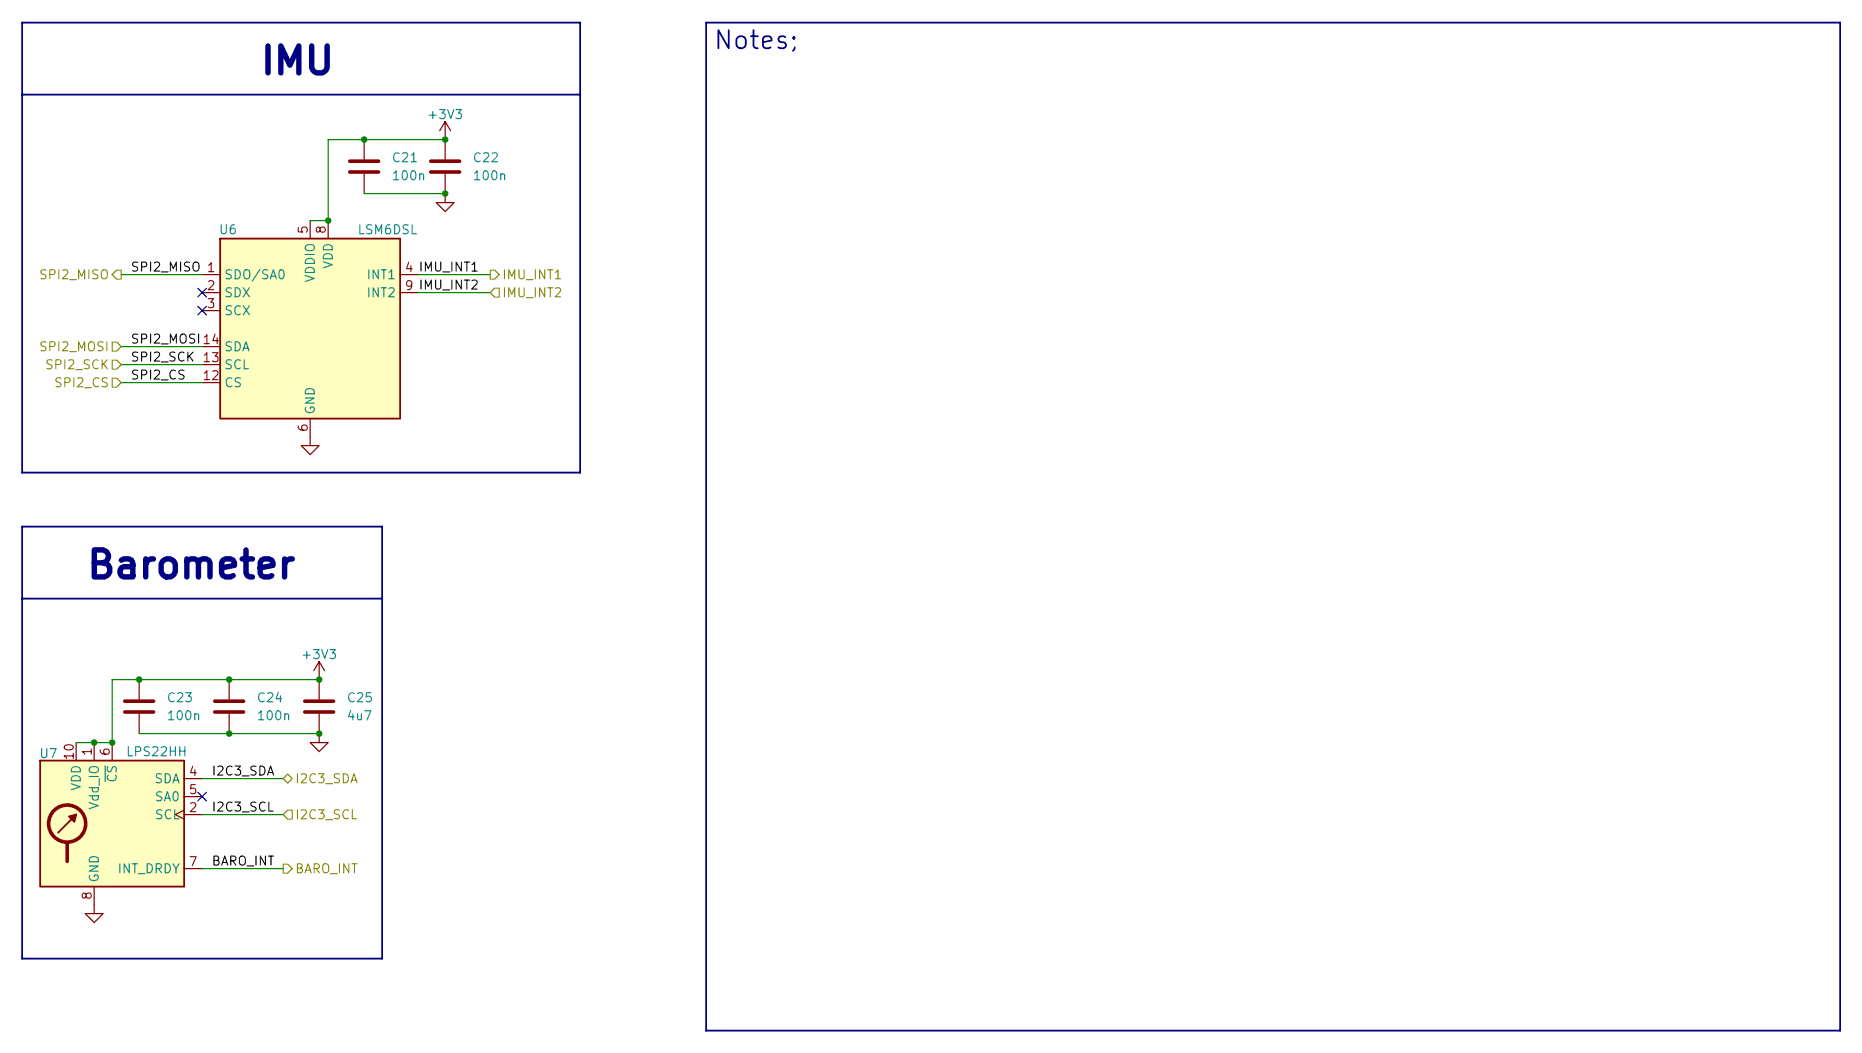
[picture p16: schematic Sensors.kicad_sch]

Parts:
C21, C22, C23, C24: 100n; C_0603_1608Metric_Pad1.08x0.95mm_HandSolder; Manufacturer Part No. CC0603KRX7R6BB104; LCSC No. C519438
C25: 4u7; C_0603_1608Metric_Pad1.08x0.95mm_HandSolder; Manufacturer Part No. CC0603KRX5R6BB475; LCSC No. C109456
U6: LSM6DSL; LGA-14_3x2.5mm_P0.5mm_LayoutBorder3x4y; Manufacturer Part No. LSM6DSLTR; Mouser No. 511-LSM6DSLTR
U7: LPS22HH; ST_HLGA-10_2x2mm_P0.5mm_LayoutBorder3x2y; Manufacturer Part No. LPS22HHTR; Mouser No. 511-LPS22HHTR

Connections:
+3V3: C21.1, C22.1, C23.1, C24.1, C25.1, U6.5 (VDDIO), U6.8 (VDD), U7.1 (Vdd_IO), U7.6 (~CS), U7.10 (VDD); also elsewhere on the board
/MCU/BARO_INT: U7.7 (INT_DRDY); also elsewhere on the board
/MCU/I2C3_SCL: U7.2 (SCL); also elsewhere on the board
/MCU/I2C3_SDA: U7.4 (SDA); also elsewhere on the board
/MCU/IMU_INT1: U6.4 (INT1); also elsewhere on the board
/MCU/IMU_INT2: U6.9 (INT2); also elsewhere on the board
/MCU/SPI2_CS: U6.12 (CS); also elsewhere on the board
/MCU/SPI2_MISO: U6.1 (SDO/SA0); also elsewhere on the board
/MCU/SPI2_MOSI: U6.14 (SDA); also elsewhere on the board
/MCU/SPI2_SCK: U6.13 (SCL); also elsewhere on the board
GND: C21.2, C22.2, C23.2, C24.2, C25.2, U6.6 (GND), U6.7 (GND), U7.3 (GND), U7.8 (GND), U7.9 (GND); also elsewhere on the board

Notes on the sheet:
Barometer
IMU
Notes;

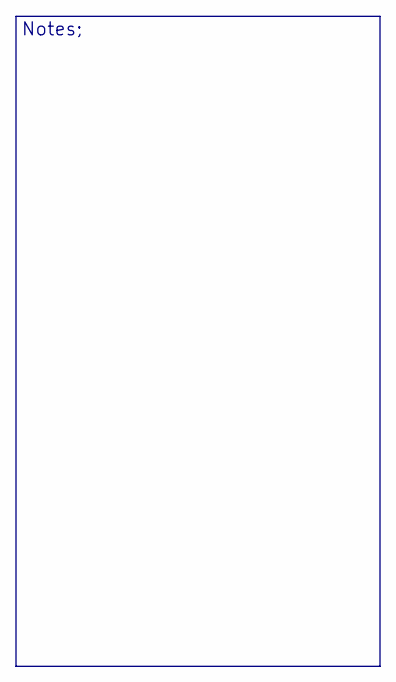
[picture p17: schematic Block_Diagram.kicad_sch]

Notes on the sheet:
Notes;

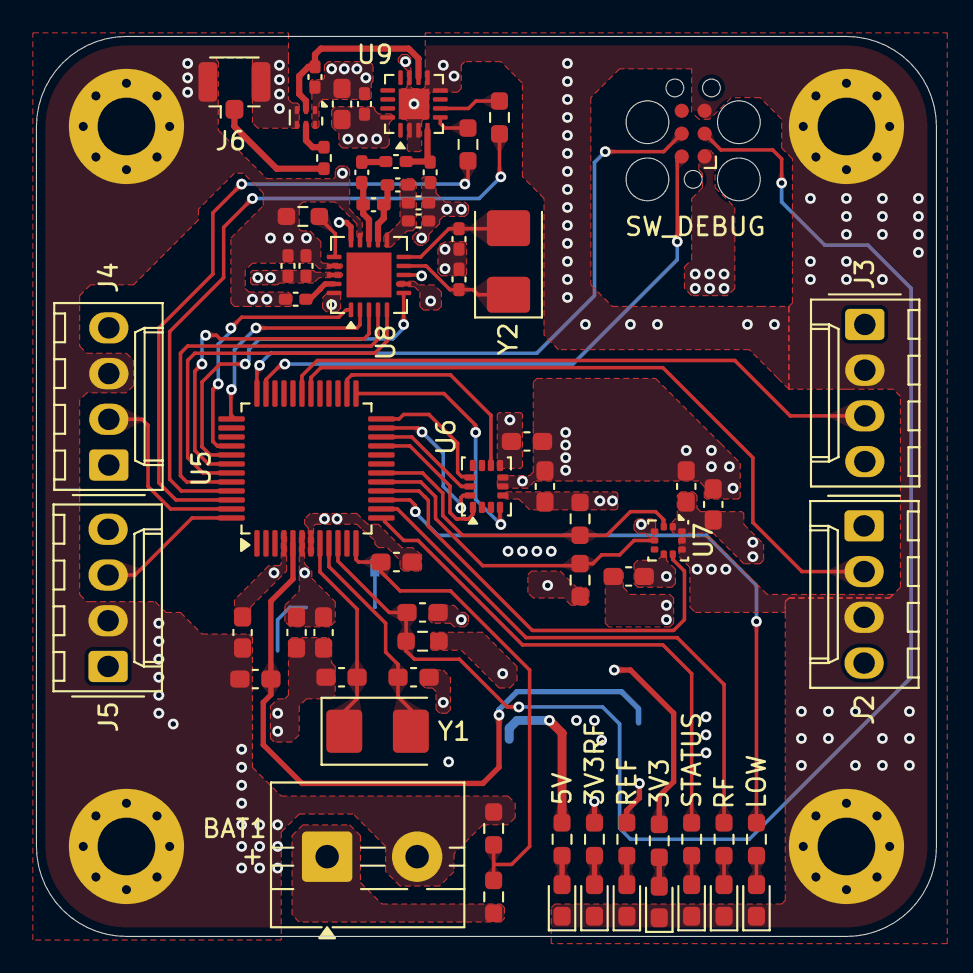
[picture p18: board Budget_FC.kicad_pcb from above]

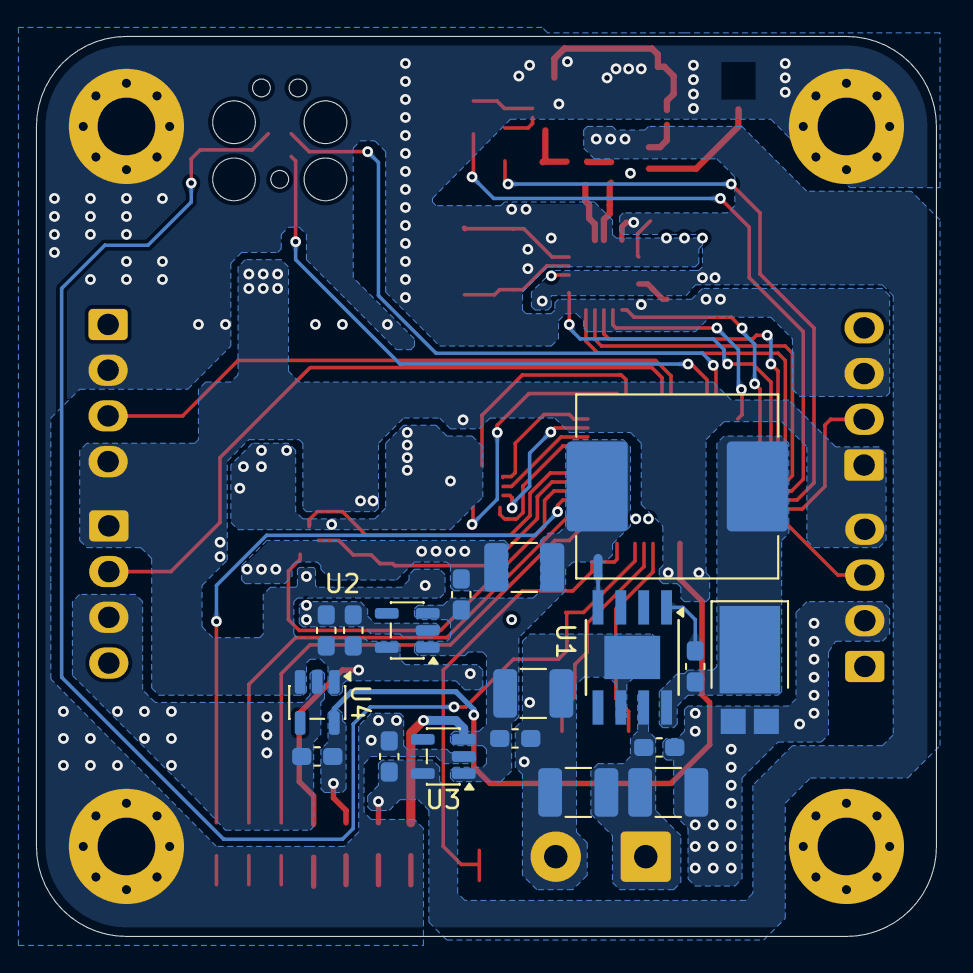
[picture p19: board Budget_FC.kicad_pcb from below]

Board: 4 copper layers, 50.0 x 50.0 mm, 89 parts (19 on the bottom side), 60 nets.

Other parts of the board:
3V3, 3V3RF, 5V: LED; LED_0603_1608Metric_Pad1.05x0.95mm_HandSolder
LOW: LED; LED_0603_1608Metric_Pad1.05x0.95mm_HandSolder
REF: LED; LED_0603_1608Metric_Pad1.05x0.95mm_HandSolder
RF: LED; LED_0603_1608Metric_Pad1.05x0.95mm_HandSolder
STATUS: LED; LED_0603_1608Metric_Pad1.05x0.95mm_HandSolder
SW_DEBUG: SW_Debug; Tag-Connect_TC2030-IDC-FP_2x03_P1.27mm_Vertical

Their connections:
+3V3: SW_DEBUG.1 (VCC); also elsewhere on the board
/MCU/LOWBAT_D: LOW.2 (A); also elsewhere on the board
/MCU/NRST: SW_DEBUG.3 (~RESET); also elsewhere on the board
/MCU/RF_D: RF.2 (A); also elsewhere on the board
/MCU/STATUS_D: STATUS.2 (A); also elsewhere on the board
/MCU/SWCLK: SW_DEBUG.4 (SWCLK); also elsewhere on the board
/MCU/SWDIO: SW_DEBUG.2 (SWDIO); also elsewhere on the board
/Power_Delivery/3V3REF_D: REF.2 (A); also elsewhere on the board
/Power_Delivery/3V3RF_D: 3V3RF.2 (A); also elsewhere on the board
/Power_Delivery/3V3_D: 3V3.2 (A); also elsewhere on the board
/Power_Delivery/5V_D: 5V.2 (A); also elsewhere on the board
GND: 3V3.1 (K), 3V3RF.1 (K), 5V.1 (K), LOW.1 (K), REF.1 (K), RF.1 (K), STATUS.1 (K), SW_DEBUG.5 (GND); also elsewhere on the board
